k1ndulez/stm32f103-diff-car/docs/命令行解析.png

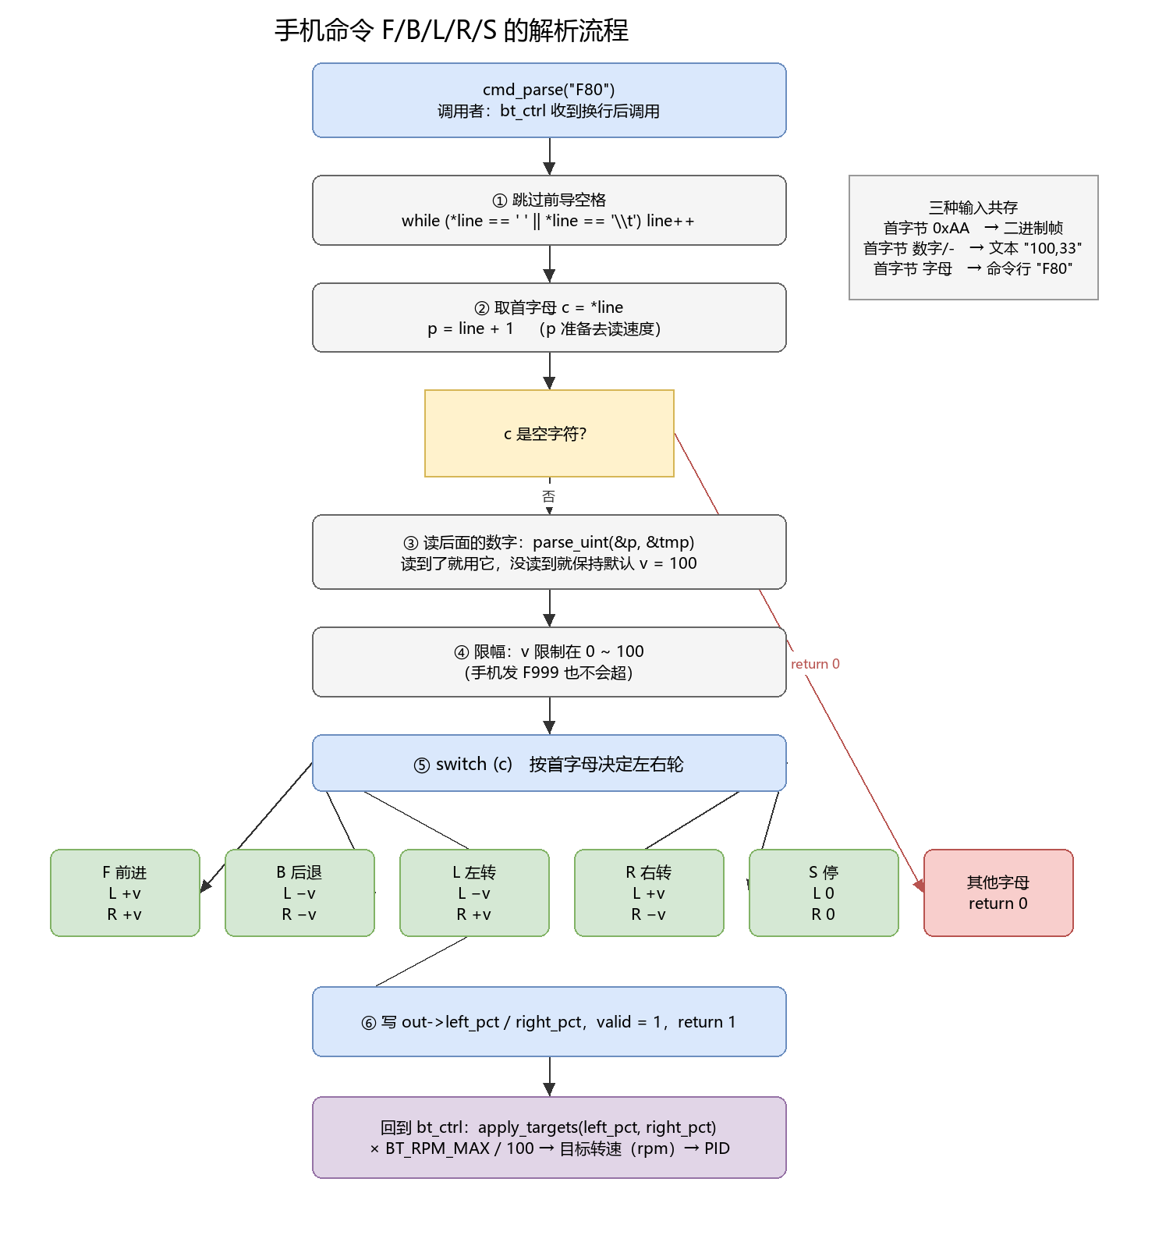
docs/命令行解析.png
