k1ndulez/stm32f103-diff-car/docs/工程架构.png

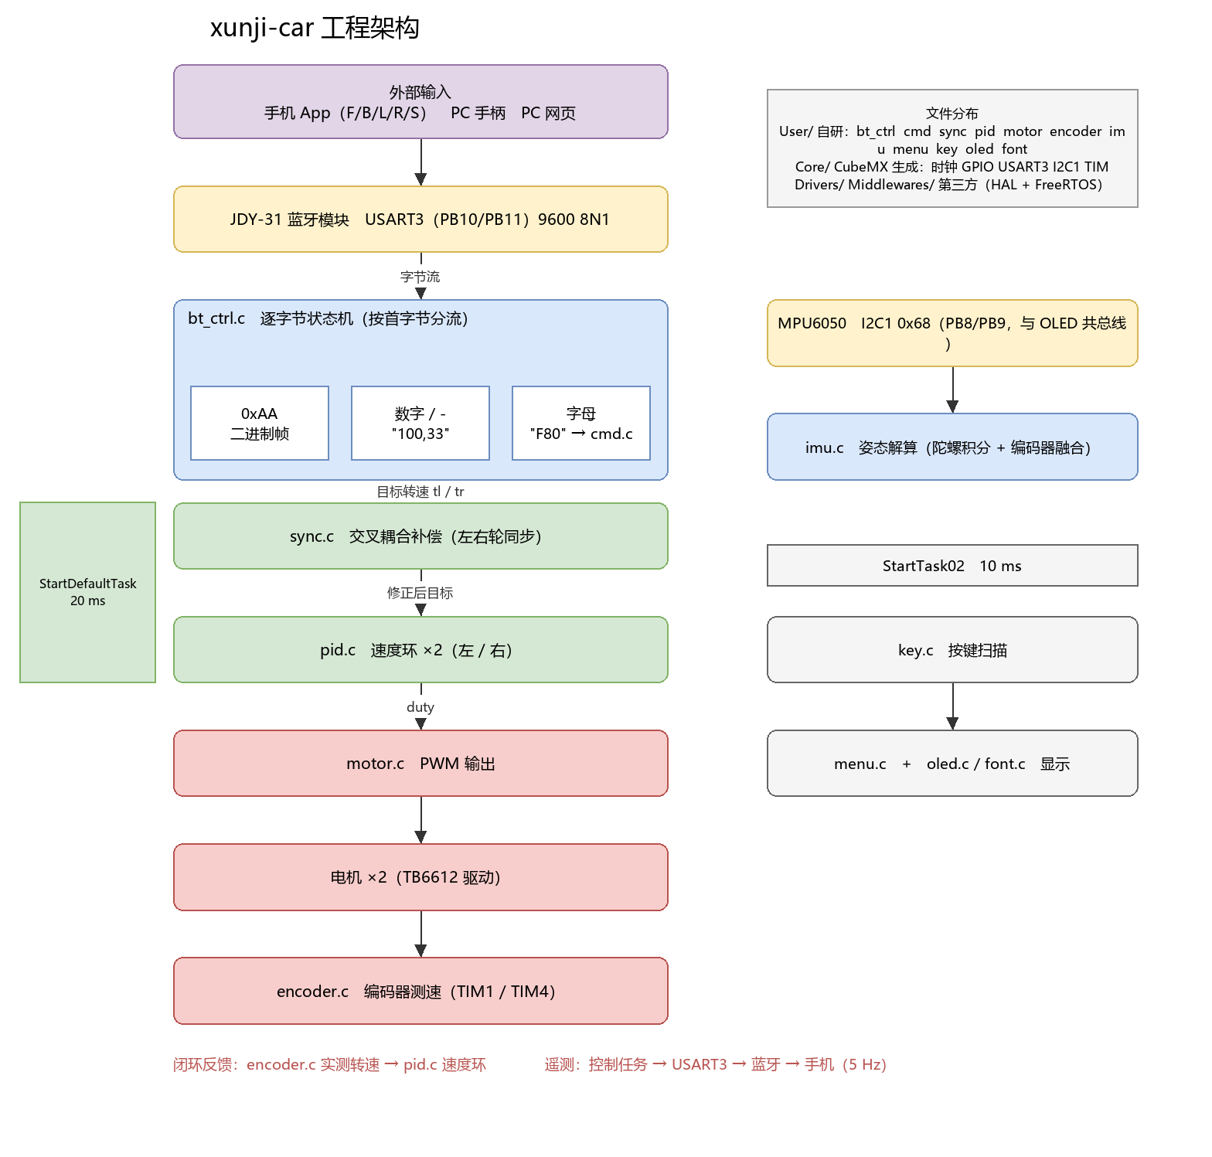
docs/工程架构.png
