k1ndulez/stm32f103-diff-car/手柄/手柄到小车-数据路径.png

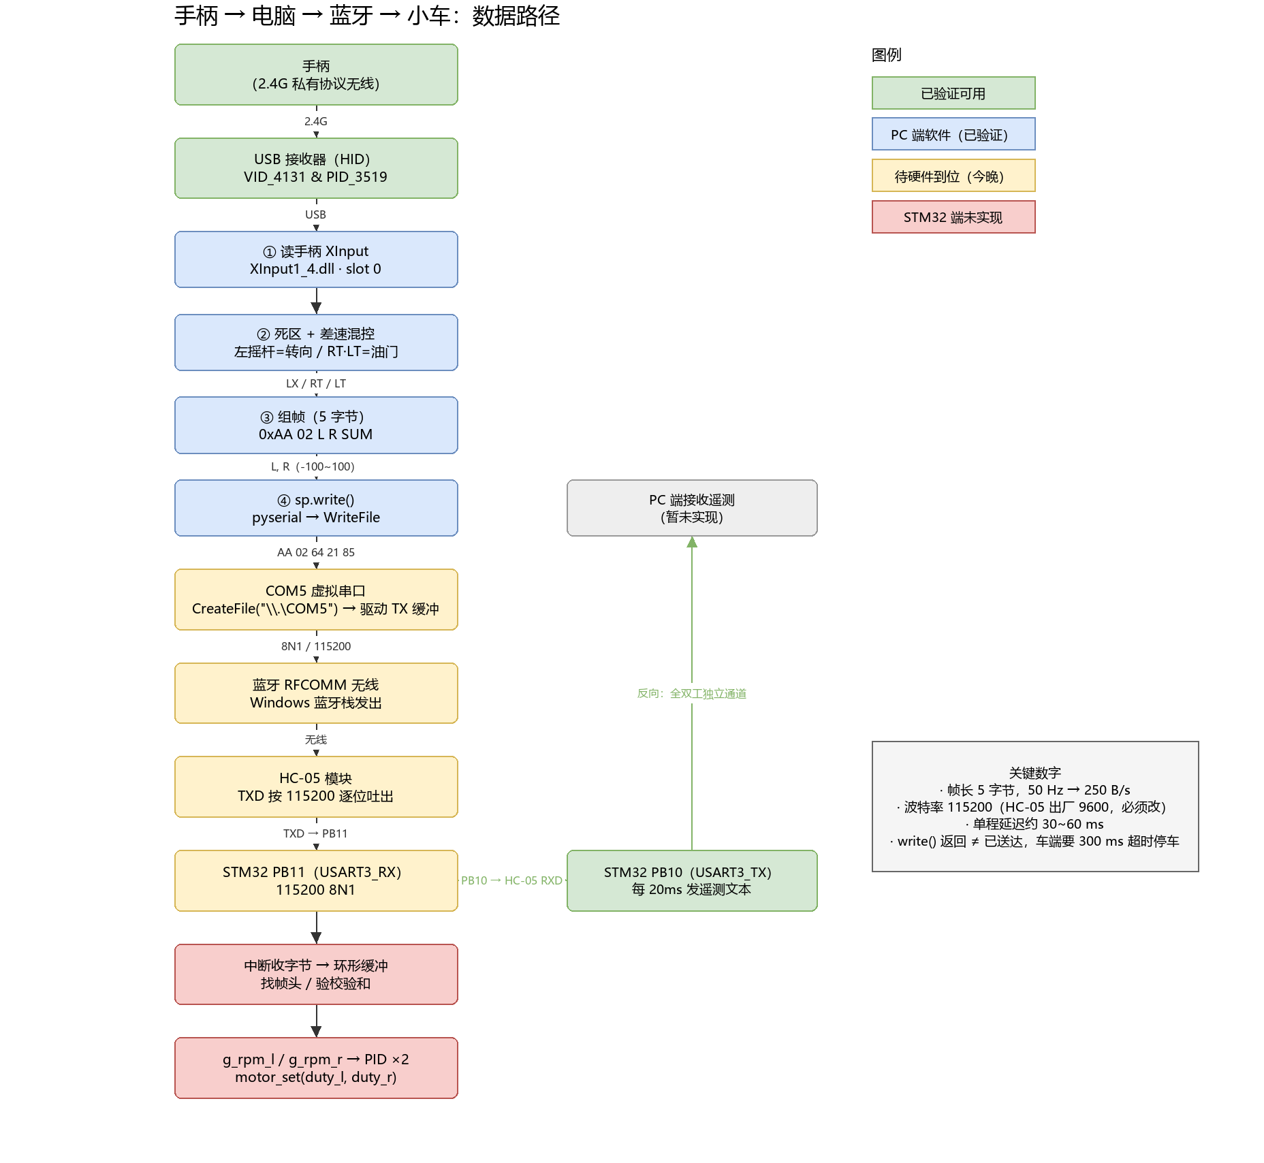
手柄/手柄到小车-数据路径.png
