k1ndulez/stm32f103-diff-car/手柄/手柄控制小车-简版.png

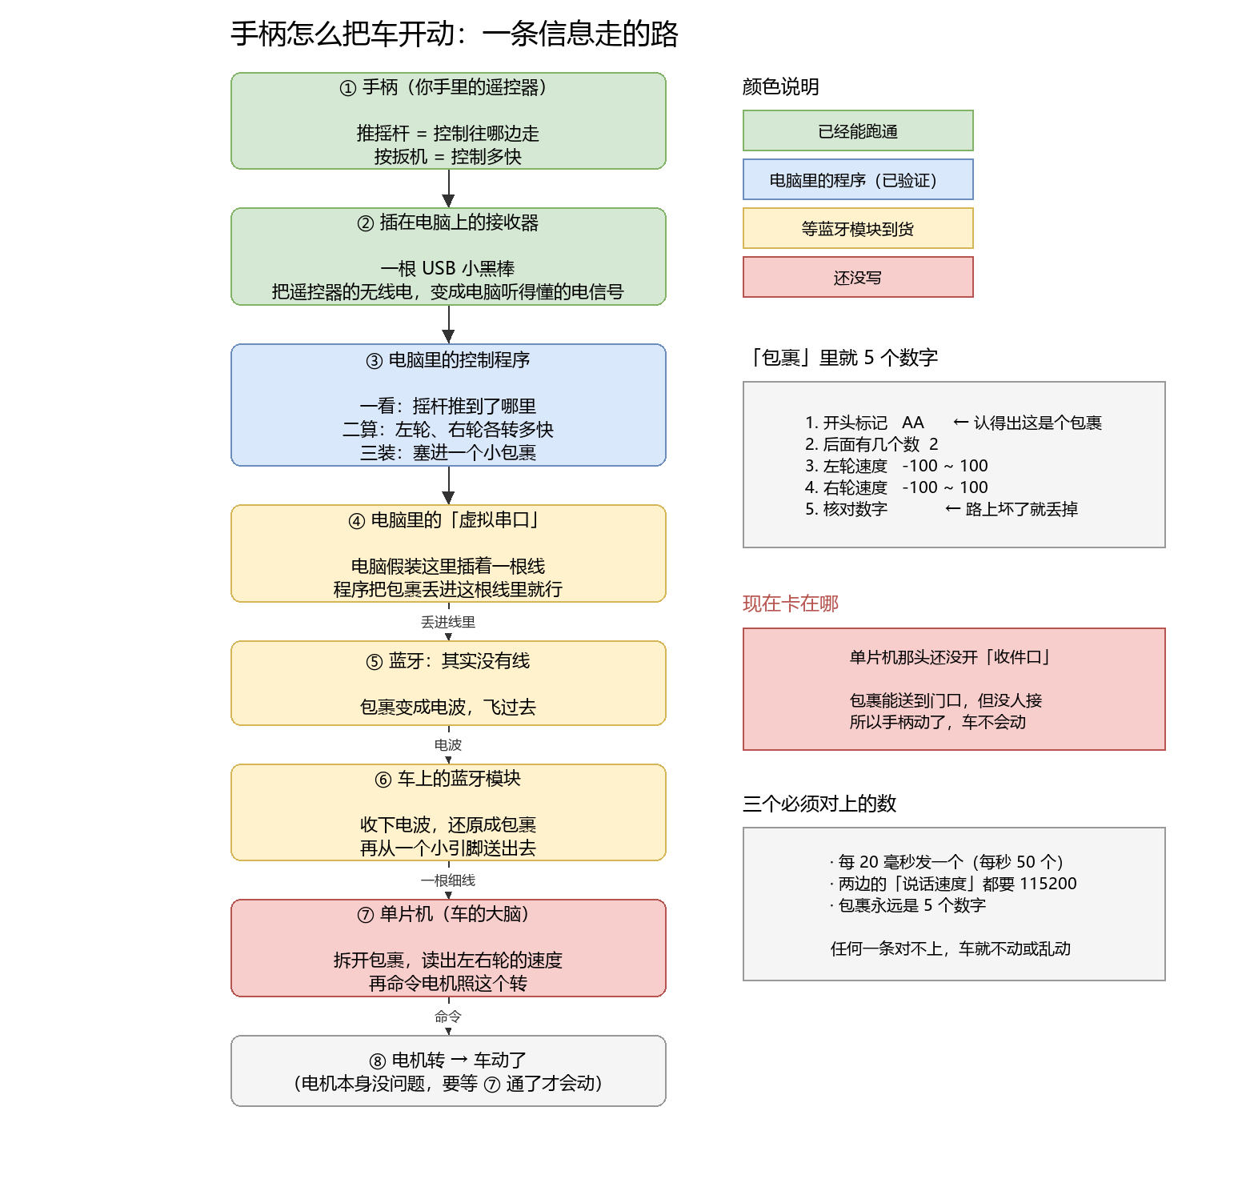
手柄/手柄控制小车-简版.png
