k1ndulez/stm32f103-diff-car/手柄/手柄控制小车-链路.png

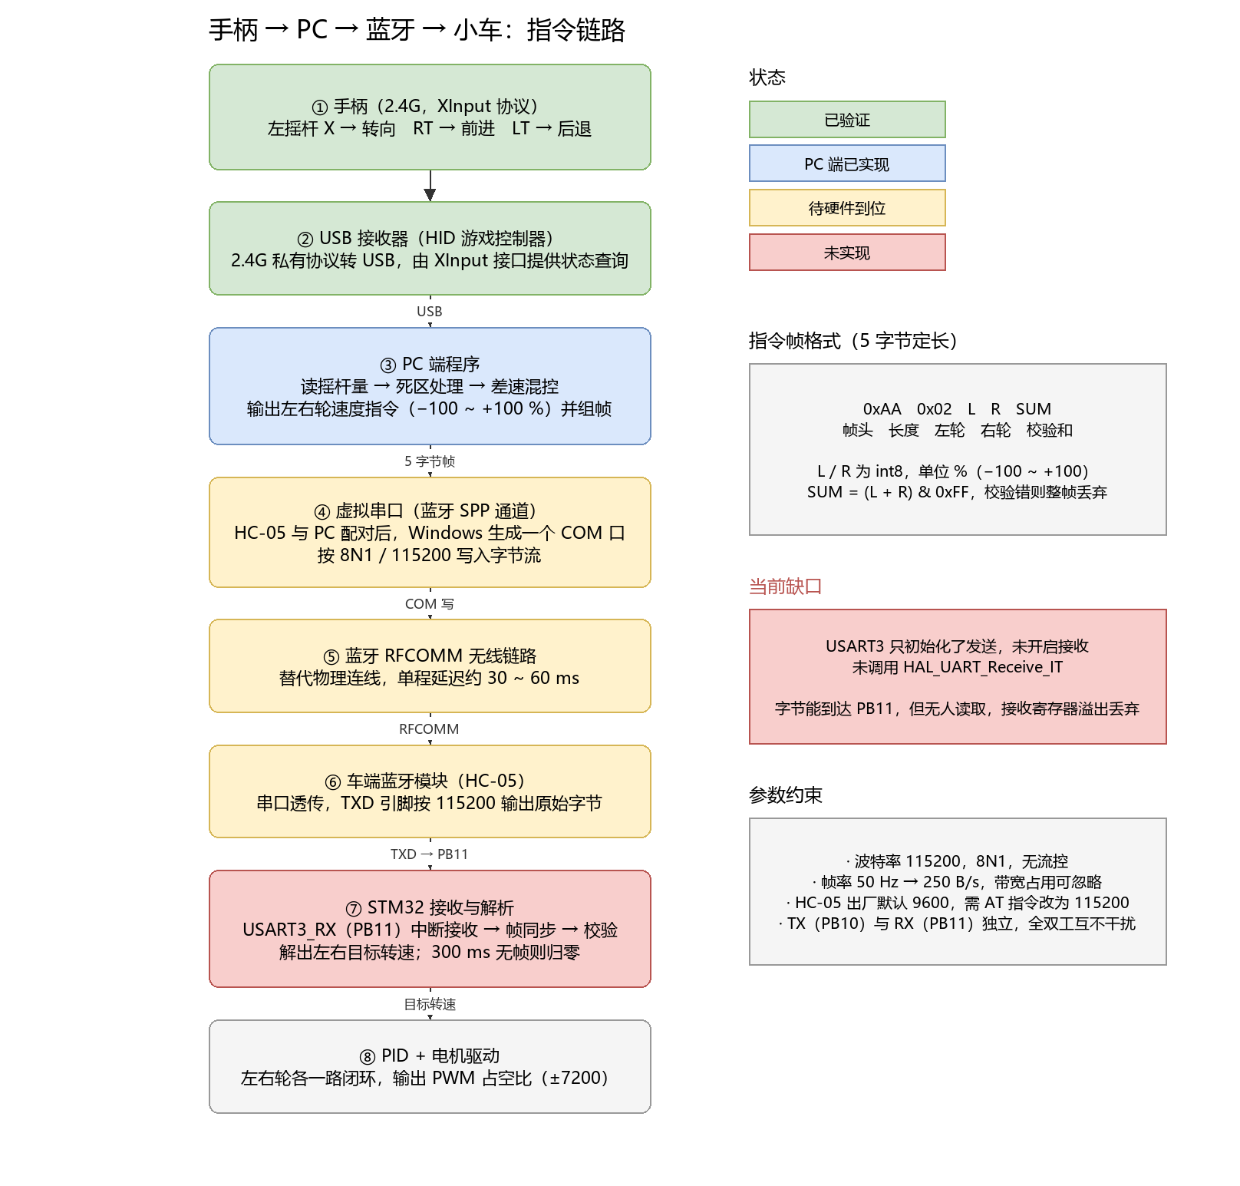
手柄/手柄控制小车-链路.png
