k1ndulez/stm32f103-diff-car/Core/Inc/main.h

#define BT_STATE_Pin GPIO_PIN_0
#define BT_STATE_GPIO_Port GPIOA
#define KEY_1_Pin GPIO_PIN_15
#define KEY_1_GPIO_Port GPIOA
#define KEY_2_Pin GPIO_PIN_3
#define KEY_2_GPIO_Port GPIOB
#define KEY_3_Pin GPIO_PIN_4
#define KEY_3_GPIO_Port GPIOB
#define KEY_4_Pin GPIO_PIN_5
#define KEY_4_GPIO_Port GPIOB
