k1ndulez/stm32f103-diff-car/(commit log)

2026-11-03 加入蓝牙遥控：双协议解析 + PC 手柄程序
    固件：
    - 新增 User/bt_ctrl.c/h：0xAA 二进制帧与文本行双协议解析，
    无 HAL 依赖，可在 PC 上做单元测试（26 项）
    - USART3 开启接收中断，波特率 9600；PA0 作蓝牙状态输入
    - freertos：左右轮独立目标转速，5 Hz 遥测输出
    - OLED 增加链路状态与左右目标显示
    PC 端（手柄/）：
    - control_car.py：手柄 -> 差速混控 -> 串口组帧
    - 4 个诊断工具：手柄读取、串口扫描、蓝牙穿透、串口教学
    - 链路图（draw.io）与使用说明
2026-11-07 chore: .gitignore 补充个人文件与桌面临时文件
2026-11-07 feat: 加入命令行解析（cmd）、IMU 与左右轮同步（sync）模块
2026-11-07 docs: 加入工程架构图、命令行解析图与网页遥控面板
2026-11-07 chore: 取消跟踪 Keil 生成的 .sct/.lst（本地文件保留，编译时自动重建）
2026-11-07 docs: 仓库更名为 stm32f103-diff-car，同步 README 标题
2026-11-07 chore: 删除未使用的空文件 speed.c/h，清理编译产物与临时备份
2026-11-08 feat: cmd 支持 Y 航向指令，新增 heading 航向闭环
    cmd 增加 CMD_TYPE_WHEELS/YAW 分流与 Y<角度> 解析；heading 实现角度 PD、±3°/35dps 到位、5s 首次到位超时锁存、HOLD 持续锁航向；CMakeLists 加入 heading.c。
2026-11-08 feat: bt_ctrl 增加 Y 航向事件与手动指令分流
    Y 指令解析后置 yaw 事件并清空轮速目标；手动指令置 drive 事件并取消待执行 Y；链路超时清空两类事件；新增 bt_take_yaw/bt_take_drive 供控制任务消费。
2026-11-08 feat: 接入航向闭环控制与网页锁航向
    freertos 20ms 任务接入 heading，Y 事件启动转向、手动指令/掉线取消；网页锁航向每 200ms 重发 Y，手动驾驶按住每 150ms 重发；方向符号与 PID 参数待上车校准。
2026-11-09 feat: 统一 yaw 方向，网页改为航向旋钮与三轮车模
    IMU yaw 改为顺时针为正并在校准后清零；heading 输出符号同步；网页航向滑条改为可拖动旋钮，车模改为前双轮+后单轮；小屏改为顶部对齐可滚动。
2026-11-09 docs: 添加周四验收任务清单
    记录网页控制 yaw 与前进后退的架构、接线、协议、按天任务、验收标准和风险兜底。
2026-11-10 fix: 调通 yaw 闭环方向，补齐航向调试遥测
    IMU_YAW_SIGN/HEADING_OUTPUT_SIGN 固定为 -1/-1；遥测增加 duty、目标 yaw、状态机和 sign_code；网页增加目标/实际 YAW 方块、YAW 波形和符号显示；补 IMU/heading draw.io 逻辑图和周四任务清单。
    [heading.c, heading.h]
2026-11-12 feat: 完善航向调试、OLED 调参与 VOFA 桥
    加入 ZUPT 静止零偏修正；航向 KP/KD/MIN/MAX 支持 OLED 在线调整；遥测改为逗号分隔并中断发送；完善 YAW 波形、时间窗口和网页发送队列；新增 VOFA+ 串口-UDP 双向桥。
    [heading.c, heading.h, imu.c, imu.h, menu.c, vofa_udp_bridge.py]
